hironaokato/atom_rc/README.md

atom_rc
=======

atom 3D Printer based on RepRap

About this printer;

This is "atom" open-source 3D printer based on RepRap project, and the base structure is Prusa i3.

All CAD data is built from scratch in Japan. 

The scale of this printer is Reprap Huxley and print area on XY is same, but Z is bit higher. 

atom aims to fit in small space since most of desktop environment is not that big in Japanese residence.

atom takes this form as a part of RepRap project and is respecting Prusa i3.

Size of bot:  340 x 275 x 270(Z)mm

Print area: 140 x 140 x 140(Z)mm

X-carriage is compatible with Huxley Extruder and its Hotend or Genkei Extruder and its Hotend.

------------------------------------------------------------------

This atom 3D Printer is RC version.
More file format will be coming soon.

------------------------------------------------------------------
x_end and x_motor has two versions which are one-piece and two pieces type.

Use ones you want.

Required mechanical parts list for main body;

M6 Threaded rod: 160mm x4,  275mm x2

M5 Threaded rod: 210mm x2

6mm linear shaft: 270mm x4, 230mm x2

GT2 OR T2.5 Timing Pulley (GT2 20tooth pulley is recommended): x2

GT2 OR T2.5 Timing Belt 6mm width: 580mm x1(X), 475mm x1(Y), these lentghs are for GT2 20tooth pulley.

Aluminum or Wood square frame: x1

Aluminum or Wood Y frog frame: x1

Teflon Bush 6mm(in) 8mm(out): x8 (if you want to use linear bearings on Y axis, then please subtract 4pcs, total 4pcs)

LM6UU Linear Bush: x4 (if you want to use linear bearings on Y axis, then please add 4pcs, total 8pcs)

624ZZ Radial Bearing: x2

M3 Nut x61minimum (+2for Genkei Extruder)

M3 washer x10

M3 10mm x38

M3 15mm x14

M3 20mm x2 (+2for Genkei Extruder)

M3 30mm x2 (+3for Genkei Extruder)

M3 Super Flat 16mm x4

M4 Nut x2

M4 washer x4

M4 25mm x2

M5 Nut x2

M6 Nut x36

M6 washer xmin4 (4 wider washers for holding sqaure frame and Y axis.)

Required Extruder and hotend;

atom can use Huxley bowden extruder hotend set OR Genkei bowden extruder hotend set in default.

------------------------------------------------------------------

RepRap official: http://www.reprap.org

RepRap Community Japan on Facebook: https://www.facebook.com/ReprapCommunityJapan

RepRap Community Japan on Mixi:  http://c.mixi.jp/reprap 

RepRap Community Japan Archive:  https://sites.google.com/site/reprapcommunityjapan/

Prusa i3 Github:  https://github.com/josefprusa/Prusa3
