hironaokato/atom_rc/dxf/bed.DXF

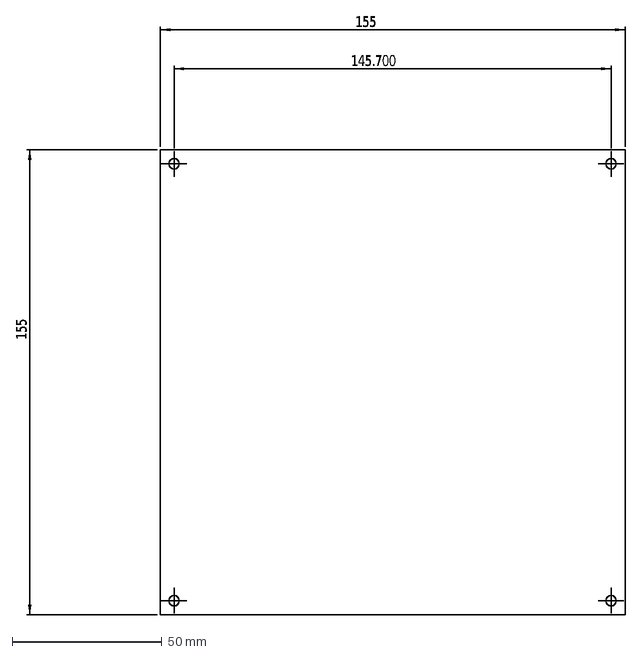
[picture p1: CAD file, 2013-06-01]
dxf/bed.DXF
155
145.700
