hironaokato/atom_rc/iges/y_end_c.IGS

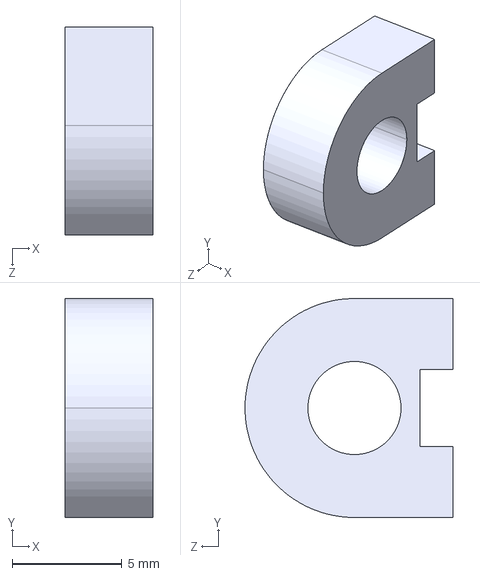
[picture p2: CAD file, 2013-11-18]
iges/y_end_c.IGS
4.00 x 10.0 x 9.50 mm
