hironaokato/atom_rc/step/DD_carriage_for_atom.STEP

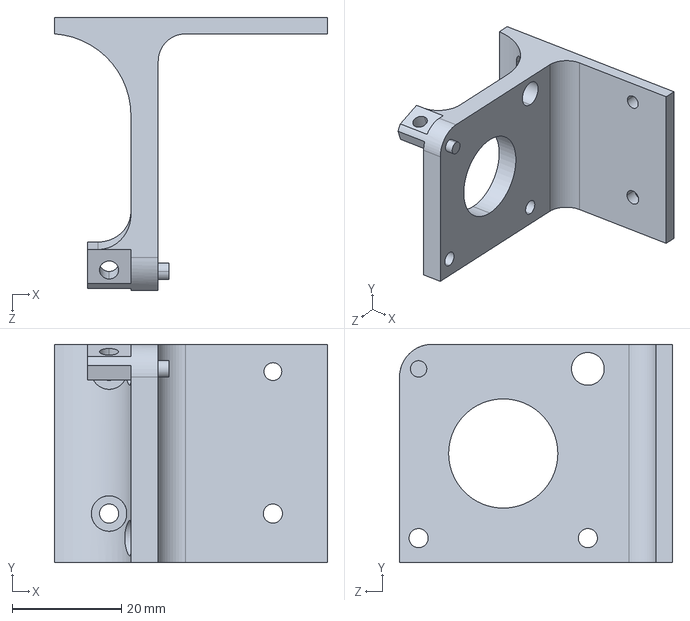
[picture p3: CAD file, 2013-11-18]
step/DD_carriage_for_atom.STEP
50.0 x 40.0 x 50.0 mm
