hironaokato/atom_rc/dxf/square_frame.DXF

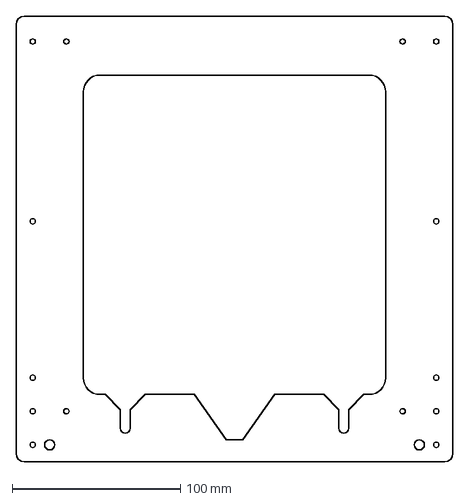
[picture p4: CAD file, 2013-06-01]
dxf/square_frame.DXF
260.0 x 265.0 mm
