hironaokato/atom_rc/iges/endstops.IGS

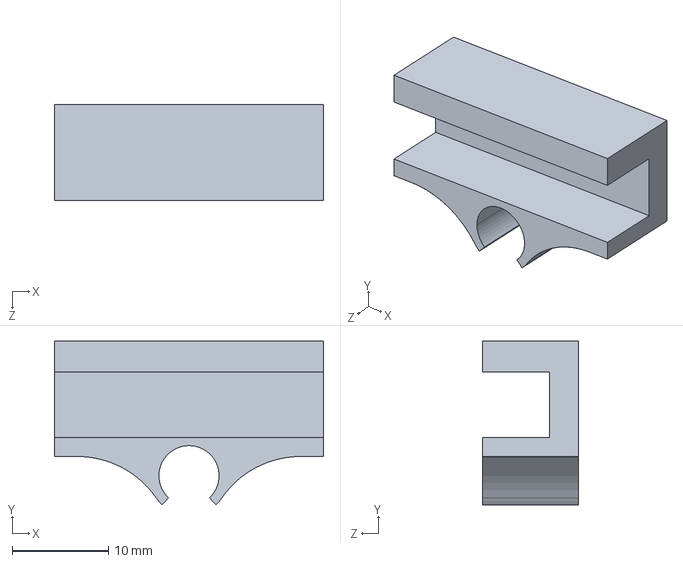
[picture p5: CAD file, 2013-11-18]
iges/endstops.IGS
28.0 x 17.0 x 10.0 mm
