hironaokato/atom_rc/step/y_belt_cramper_b_2.STEP

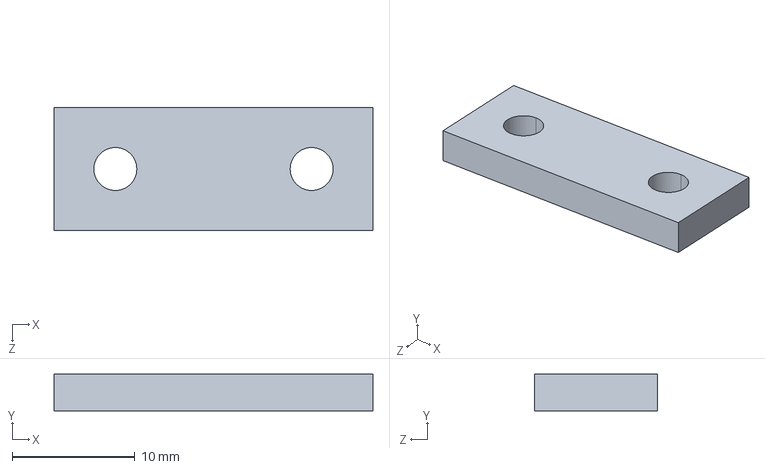
[picture p6: CAD file, 2013-06-24]
step/y_belt_cramper_b_2.STEP
26.0 x 3.00 x 10.0 mm
