hironaokato/atom_rc/dxf/y_frog.DXF

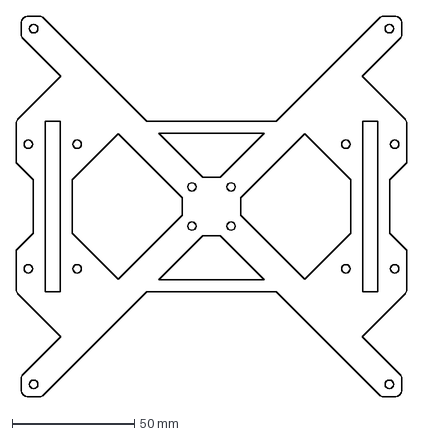
[picture p7: CAD file, 2013-06-01]
dxf/y_frog.DXF
160.0 x 155.7 mm
