hironaokato/atom_rc/iges/y_foot.IGS

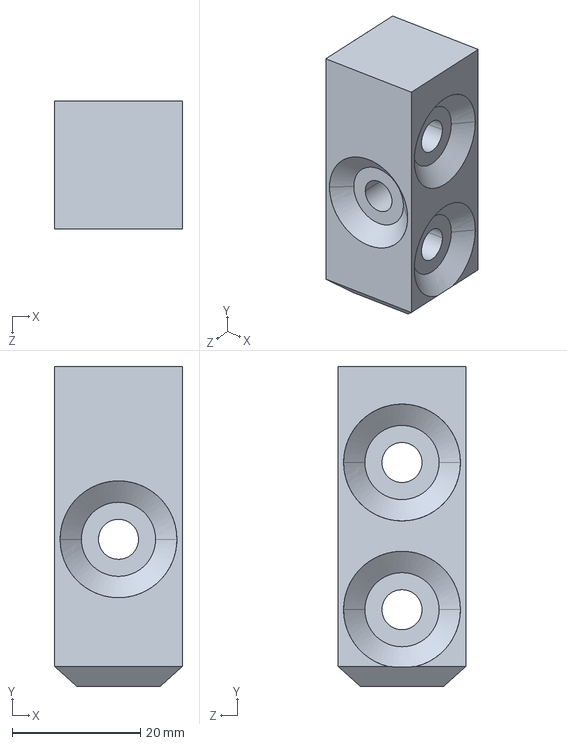
[picture p8: CAD file, 2013-11-18]
iges/y_foot.IGS
20.0 x 50.0 x 20.0 mm
