hironaokato/atom_rc/step/x_motor split_a.STEP

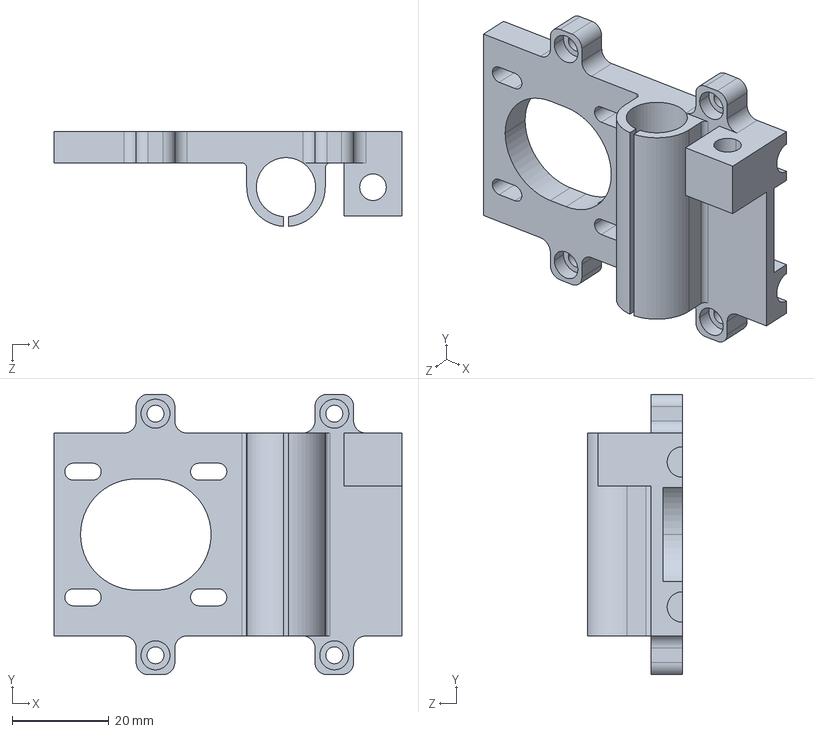
[picture p9: CAD file, 2013-06-24]
step/x_motor split_a.STEP
72.0 x 58.0 x 19.6 mm
