hironaokato/atom_rc/stl/X_carriage_lm_ver_c.STL

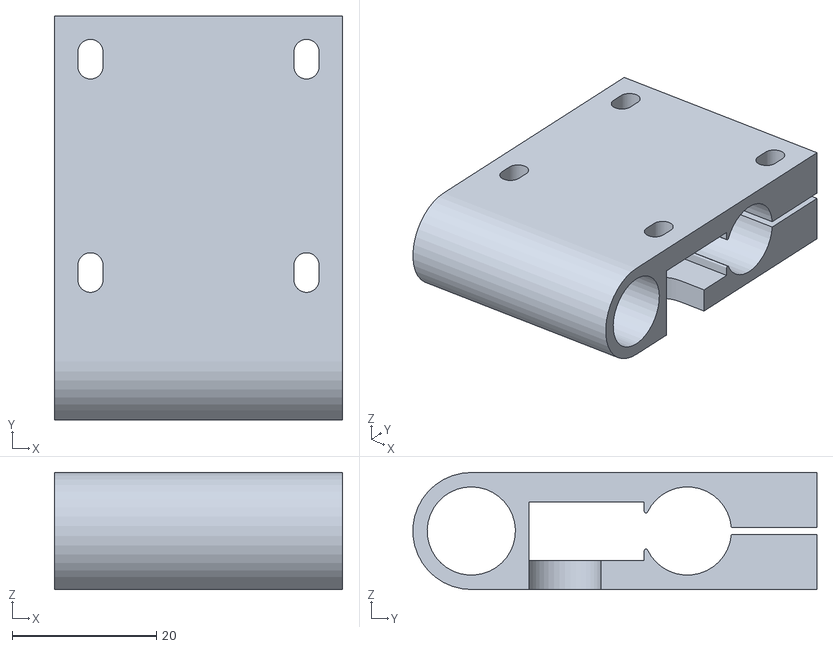
[picture p10: CAD file, 2014-03-04]
stl/X_carriage_lm_ver_c.STL
40.0 x 56.1 x 16.2
