hironaokato/atom_rc/iges/z_couple.IGS

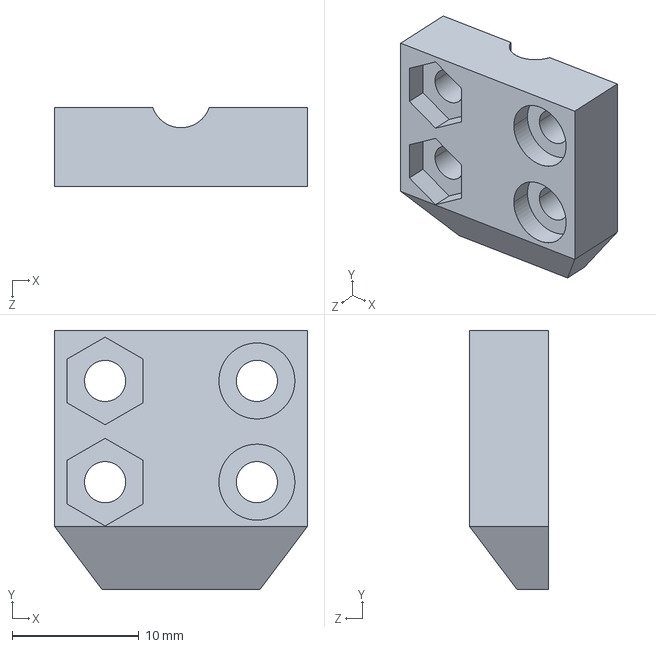
[picture p11: CAD file, 2013-11-18]
iges/z_couple.IGS
20.0 x 20.5 x 6.25 mm
