hironaokato/atom_rc/step/x_motor.STEP

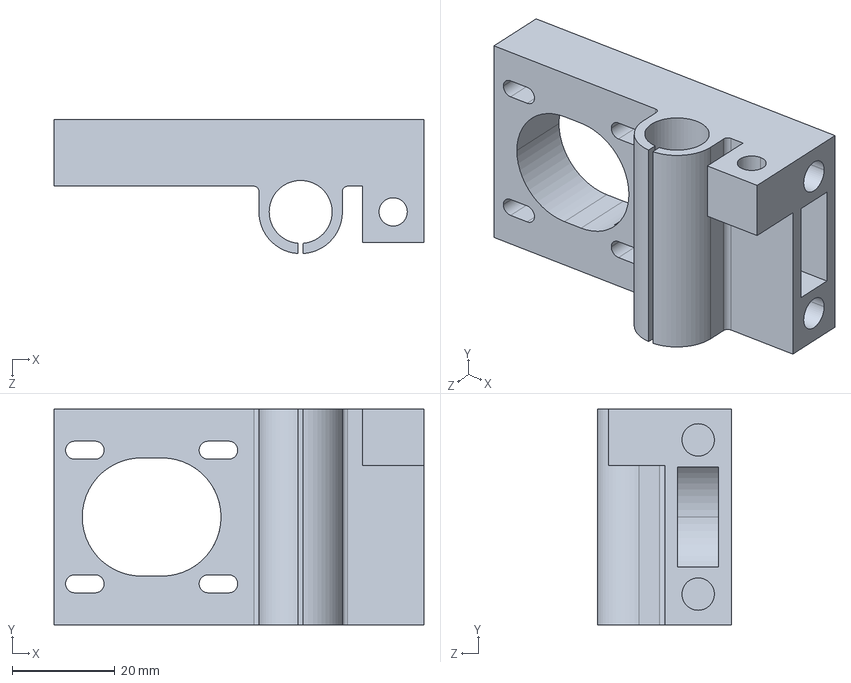
[picture p12: CAD file, 2013-06-24]
step/x_motor.STEP
72.0 x 42.0 x 26.1 mm
