hironaokato/atom_rc/stl/y_bush_holder_rimless.STL

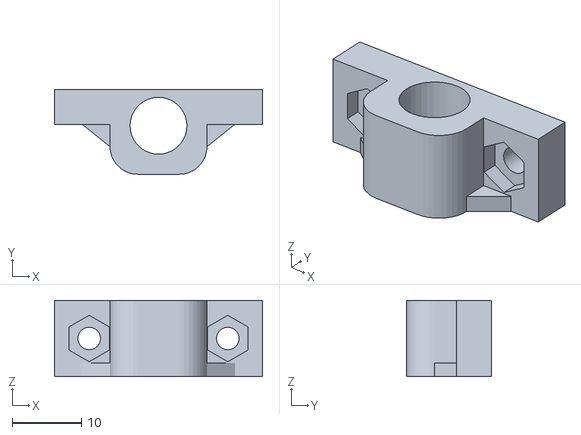
[picture p13: CAD file, 2013-06-02]
stl/y_bush_holder_rimless.STL
30.0 x 12.2 x 11.0
