hironaokato/atom_rc/step/z_end_left.STEP

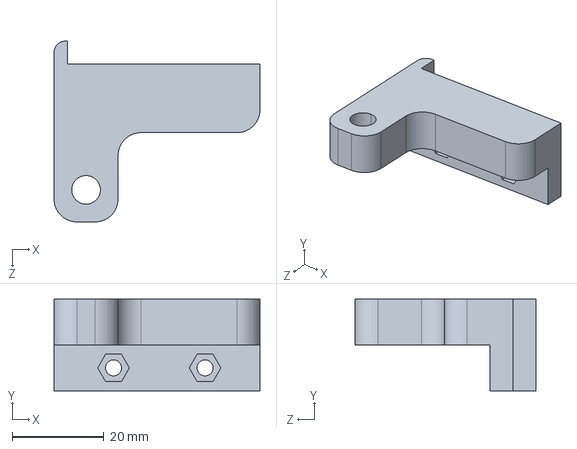
[picture p14: CAD file, 2013-06-24]
step/z_end_left.STEP
45.0 x 20.0 x 39.5 mm
