hironaokato/atom_rc/stl/x_end.STL

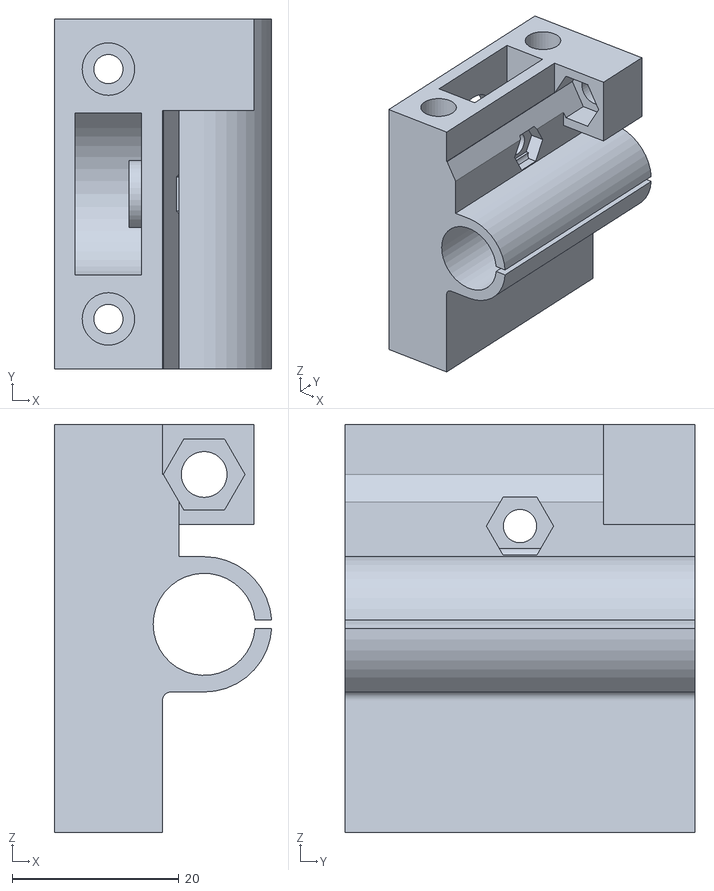
[picture p15: CAD file, 2013-06-02]
stl/x_end.STL
26.1 x 42.0 x 49.0
