hironaokato/atom_rc/iges/y_bush_holder.IGS

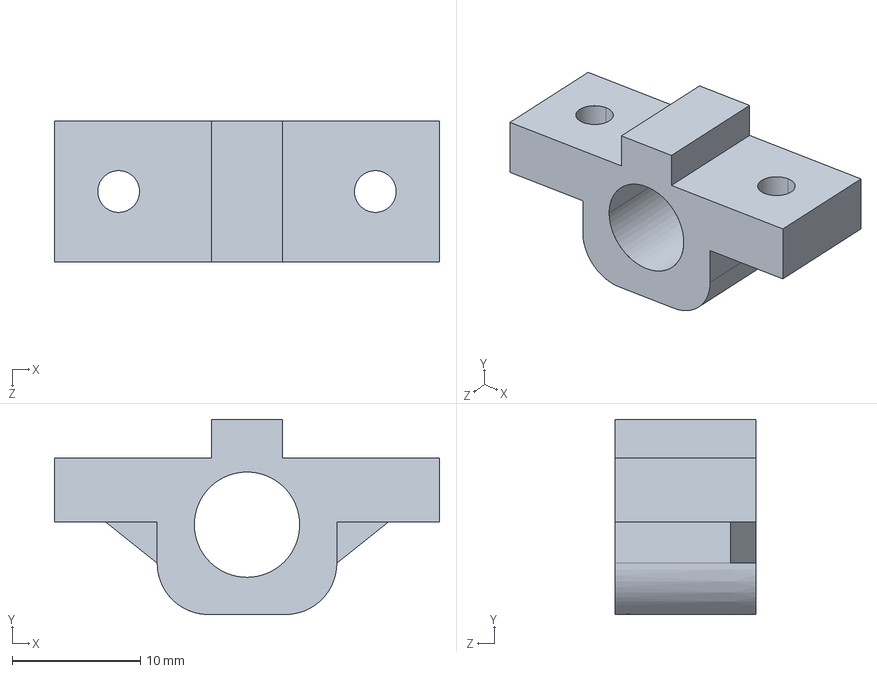
[picture p16: CAD file, 2013-11-18]
iges/y_bush_holder.IGS
30.0 x 15.2 x 11.0 mm
