hironaokato/atom_rc/step/x_carriage_b.STEP

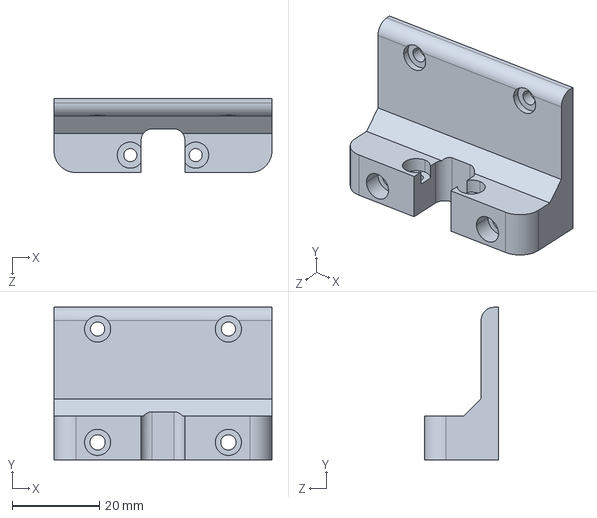
[picture p17: CAD file, 2013-06-24]
step/x_carriage_b.STEP
50.0 x 35.0 x 17.0 mm
