hironaokato/atom_rc/stl/atom_rc_assem.STL

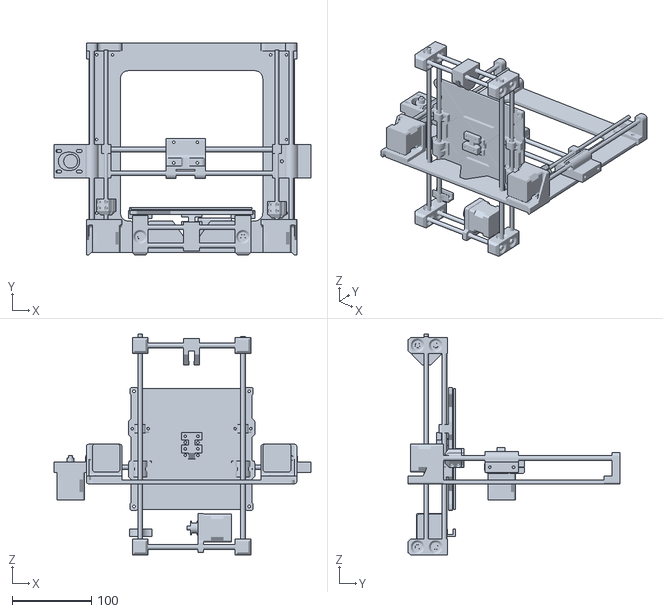
[picture p18: CAD file, 2013-05-15]
stl/atom_rc_assem.STL
325.0 x 268.0 x 279.4
