hironaokato/atom_rc/iges/y_belt_clamper_a.IGS

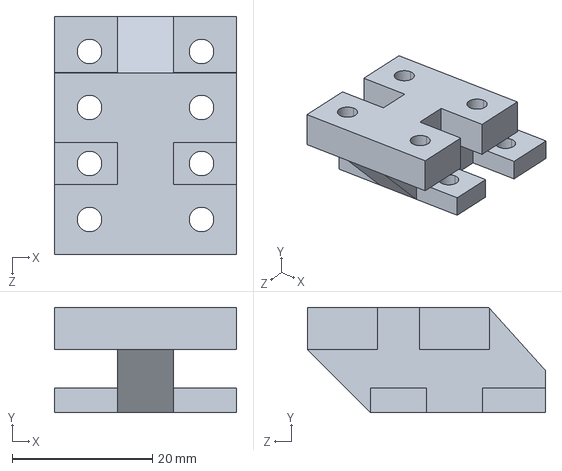
[picture p19: CAD file, 2013-11-18]
iges/y_belt_clamper_a.IGS
26.0 x 15.0 x 34.0 mm
