hironaokato/atom_rc/step/y_end_a.STEP

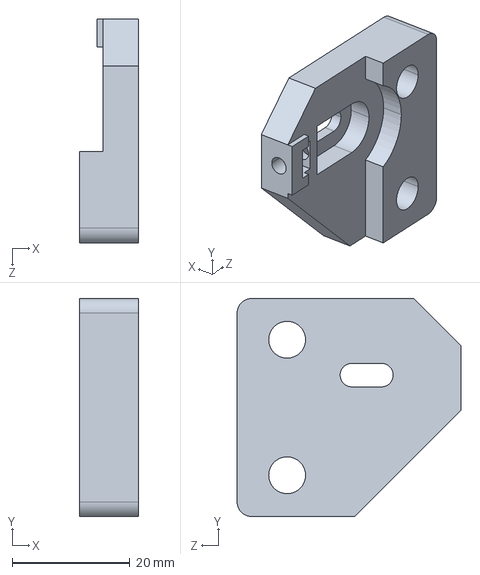
[picture p20: CAD file, 2013-06-24]
step/y_end_a.STEP
10.0 x 37.0 x 38.0 mm
