hironaokato/atom_rc/stl/y_lmbush_holder.STL

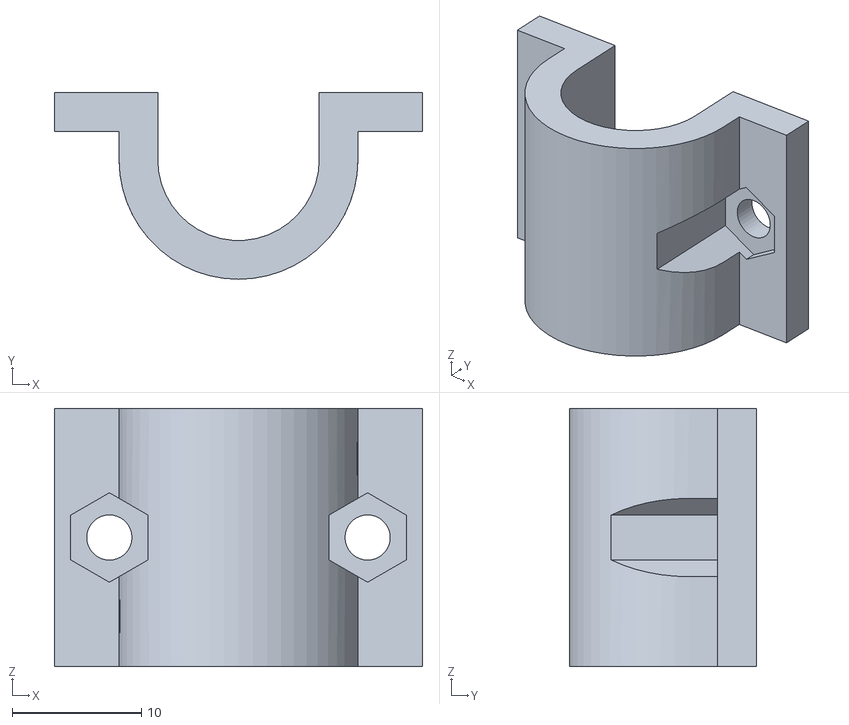
[picture p21: CAD file, 2013-05-13]
stl/y_lmbush_holder.STL
28.5 x 14.4 x 20.0
