hironaokato/atom_rc/step/x_end split_a.STEP

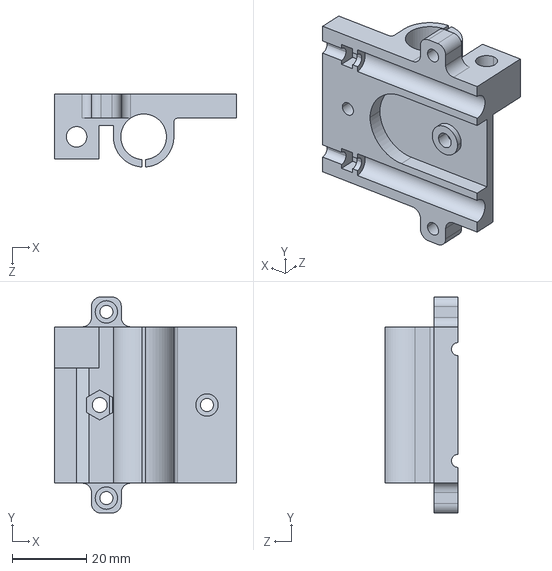
[picture p23: CAD file, 2013-06-24]
step/x_end split_a.STEP
49.0 x 58.0 x 19.6 mm
