hironaokato/atom_rc/step/x_end_b.STEP

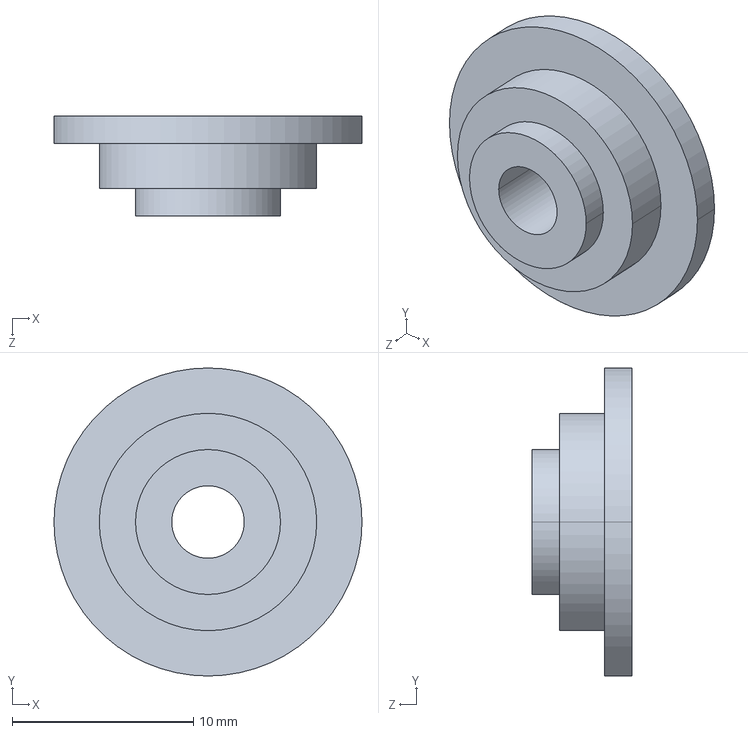
[picture p24: CAD file, 2013-06-24]
step/x_end_b.STEP
17.0 x 17.0 x 5.50 mm
