hironaokato/atom_rc/step/x_carriage_a.STEP

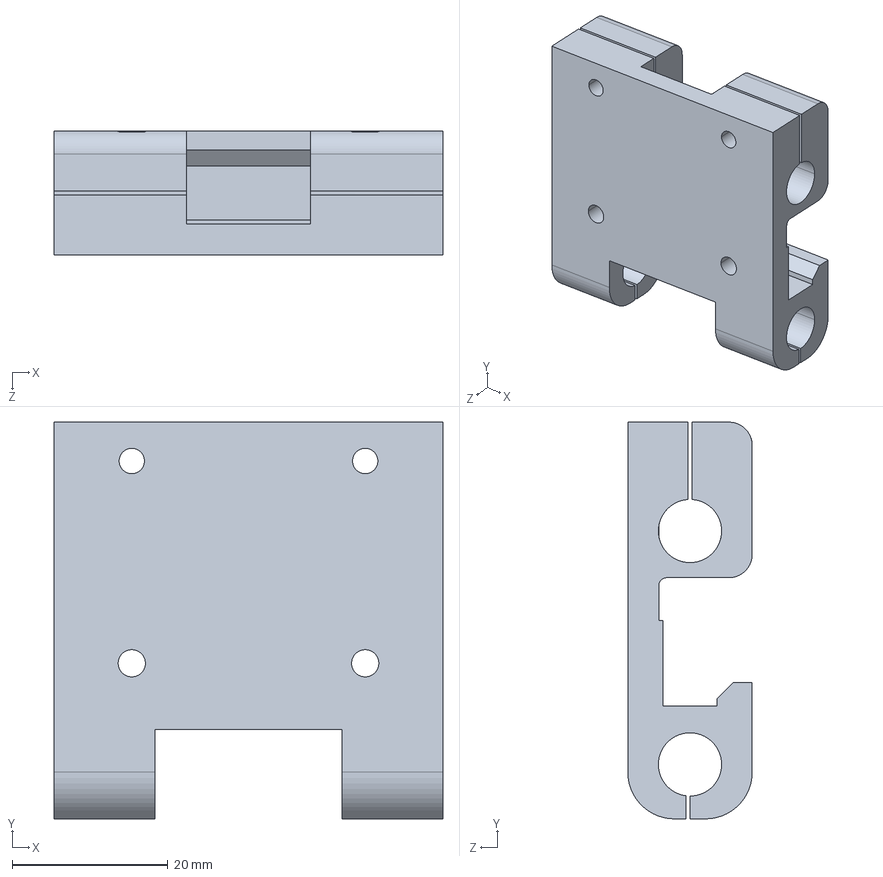
[picture p26: CAD file, 2013-06-24]
step/x_carriage_a.STEP
50.0 x 51.0 x 16.0 mm
