hironaokato/atom_rc/step/z_couple_4.STEP

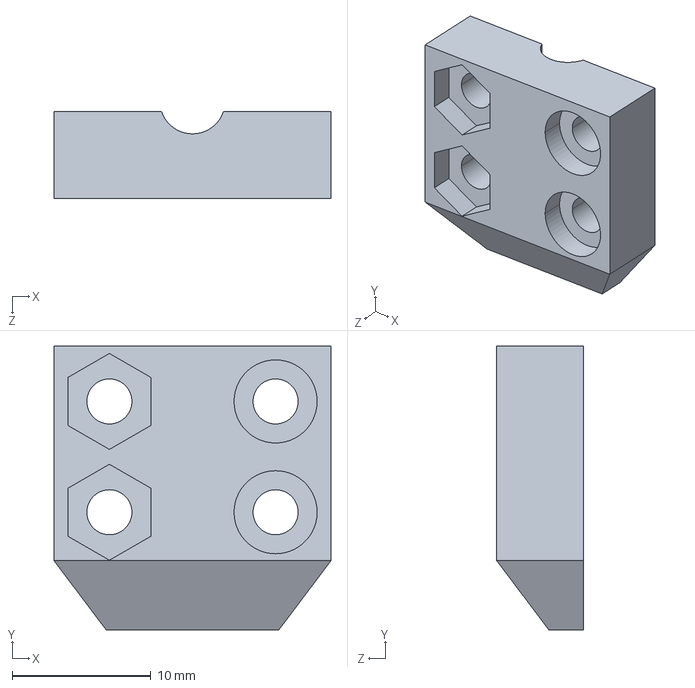
[picture p27: CAD file, 2013-06-24]
step/z_couple_4.STEP
20.0 x 20.5 x 6.25 mm
