hironaokato/atom_rc/step/x_carriage_c.STEP

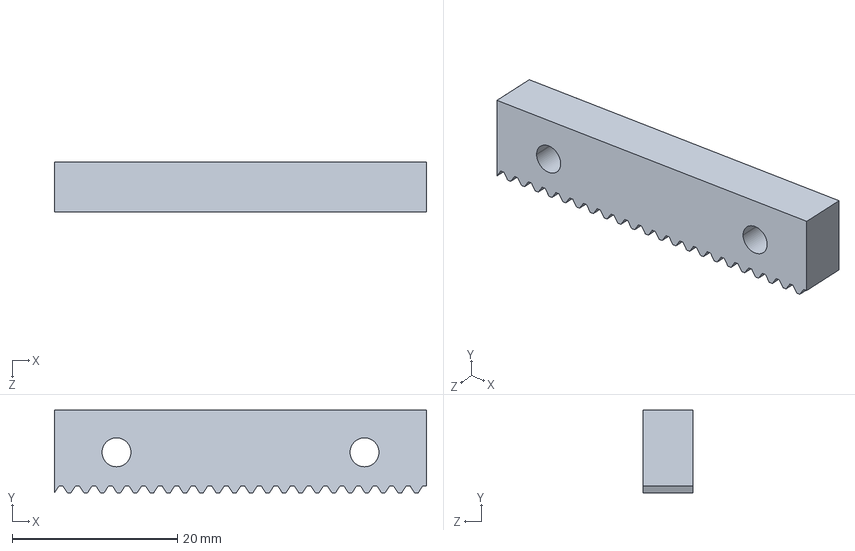
[picture p28: CAD file, 2013-06-24]
step/x_carriage_c.STEP
45.0 x 10.0 x 6.00 mm
