hironaokato/atom_rc/step/y_motor.STEP

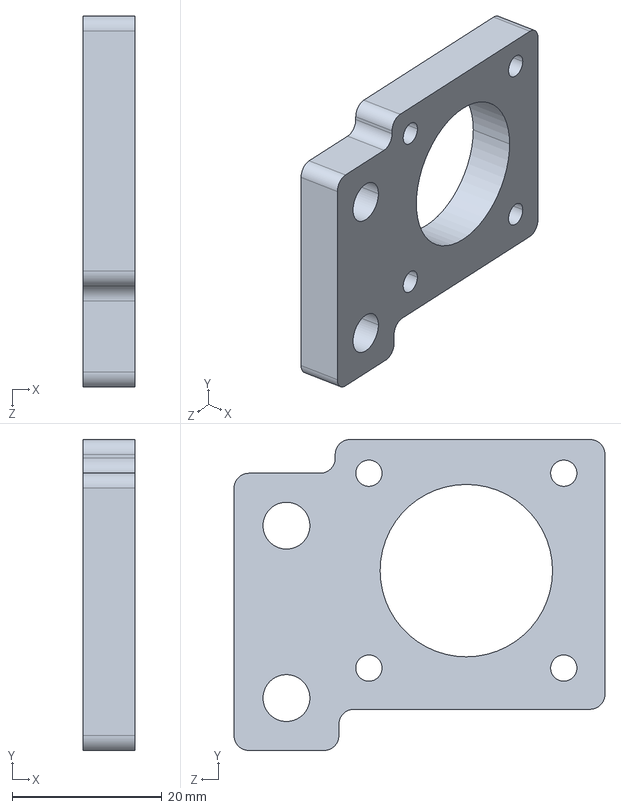
[picture p29: CAD file, 2013-06-24]
step/y_motor.STEP
7.00 x 41.5 x 49.5 mm
