hironaokato/atom_rc/step/x_end split_b.STEP

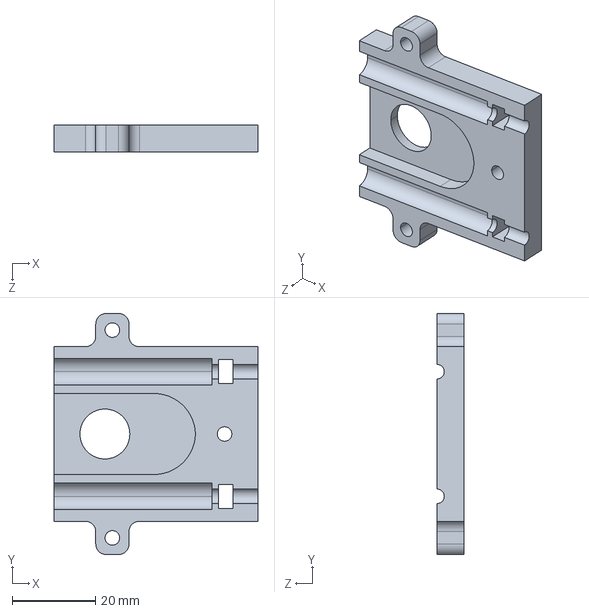
[picture p30: CAD file, 2013-06-24]
step/x_end split_b.STEP
49.0 x 58.0 x 6.50 mm
