hironaokato/atom_rc/step/Spring Holder DD Extruder.STEP

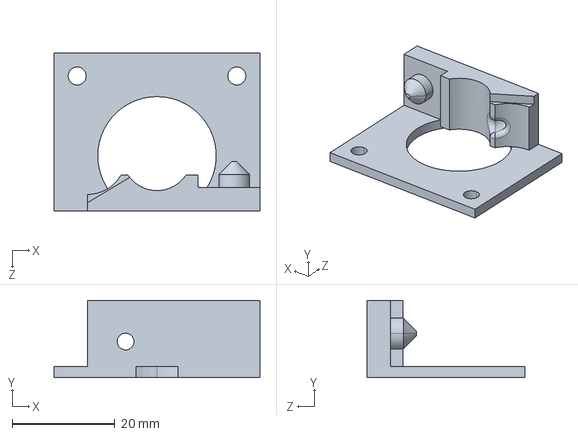
[picture p31: CAD file, 2013-06-24]
step/Spring Holder DD Extruder.STEP
40.0 x 15.0 x 30.8 mm
