hironaokato/atom_rc/step/x_motor split_b.STEP

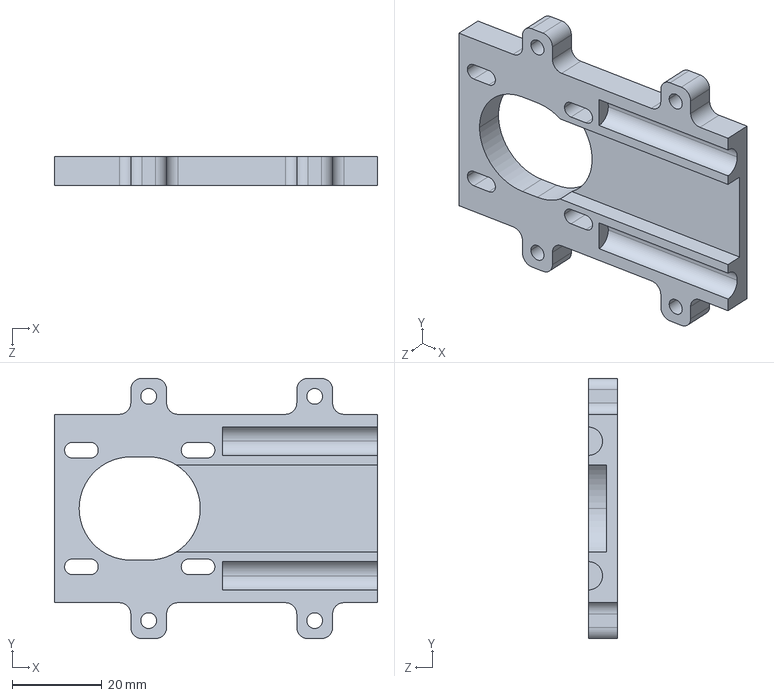
[picture p32: CAD file, 2013-06-24]
step/x_motor split_b.STEP
72.0 x 58.0 x 6.50 mm
