hironaokato/atom_rc/(list of files, cad)

Other CAD files:
iges/y_belt_clamper_b.IGS
step/y_foot_4.STEP
step/y_end_b.STEP
step/x_end_a.STEP
step/z_end_right.STEP
step/y_end_c_2.STEP
step/y_belt_cramper_a.STEP
step/z_motor_right.STEP
step/endstops_4.STEP
step/y_bush_holder_4.STEP
iges/x_carriage_a.IGS
iges/x_carriage_b.IGS
iges/x_carriage_c.IGS
iges/x_end a.IGS
iges/x_end b.IGS
iges/x_motor.IGS
iges/y_end_a.IGS
iges/y_end_b.IGS
iges/y_motor.IGS
iges/z_end_left.IGS
iges/z_end_right.IGS
iges/z_motor_left.IGS
iges/z_motor_right.IGS
stl/DD_carriage_for_atom.STL
stl/X_carriage_lm_ver_a.STL
stl/X_carriage_lm_ver_b.STL
stl/endstops.STL
stl/x_carriage_a.STL
stl/x_carriage_b.STL
stl/x_carriage_c.STL
stl/x_end_b.STL
stl/x_motor.STL
stl/y_belt_clamper_a.STL
stl/y_belt_clamper_b.STL
stl/y_bush_holder.STL
stl/y_end_a.STL
stl/y_end_b.STL
stl/y_end_c.STL
stl/y_foot.STL
stl/y_motor.STL
stl/z_couple.STL
stl/z_end_left.STL
stl/z_end_right.STL
stl/z_motor_left.STL
stl/z_motor_right.STL
