hironaokato/atom_rc/pdf/square_frame.PDF

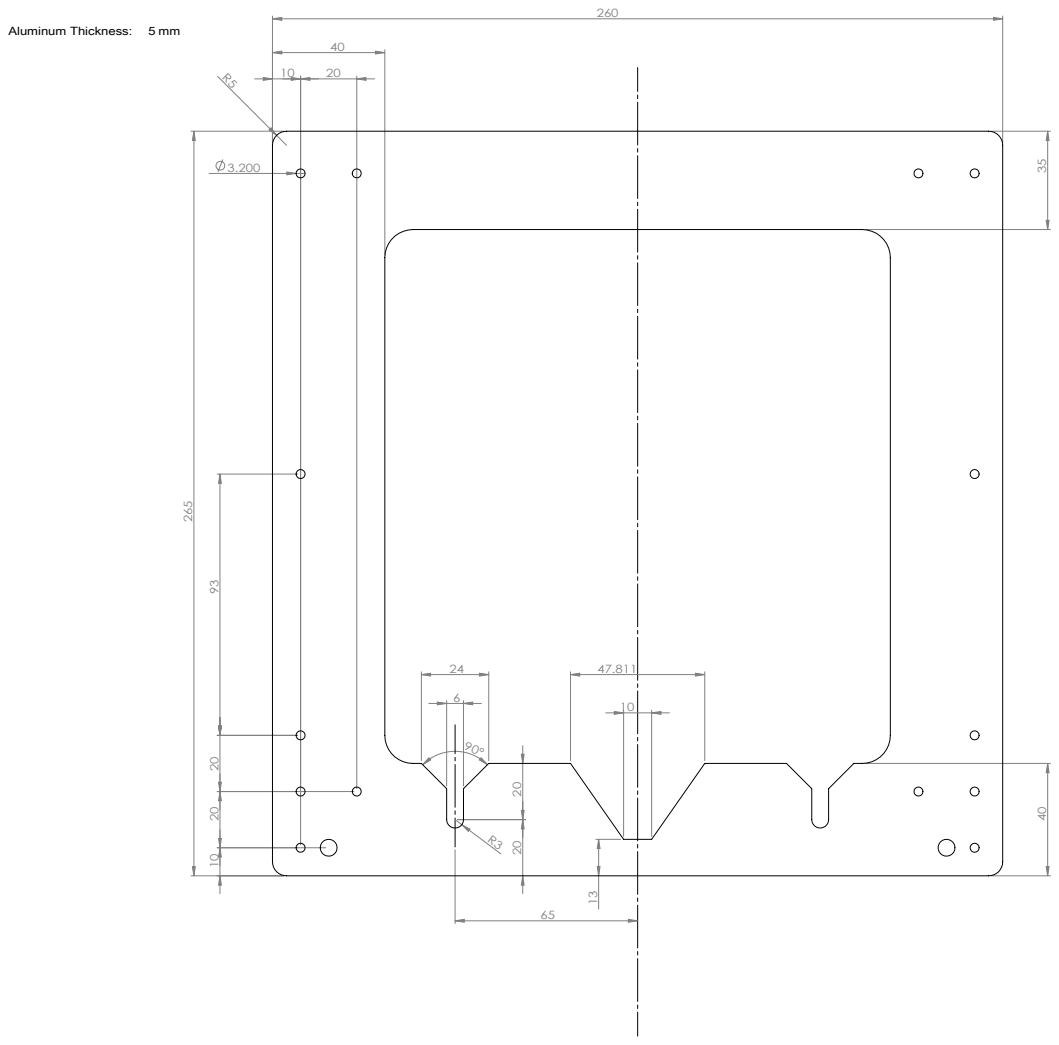
[picture p33: page 1]
Aluminum Thickness: ５mm
