hironaokato/atom_rc/pdf/jig_050713.pdf

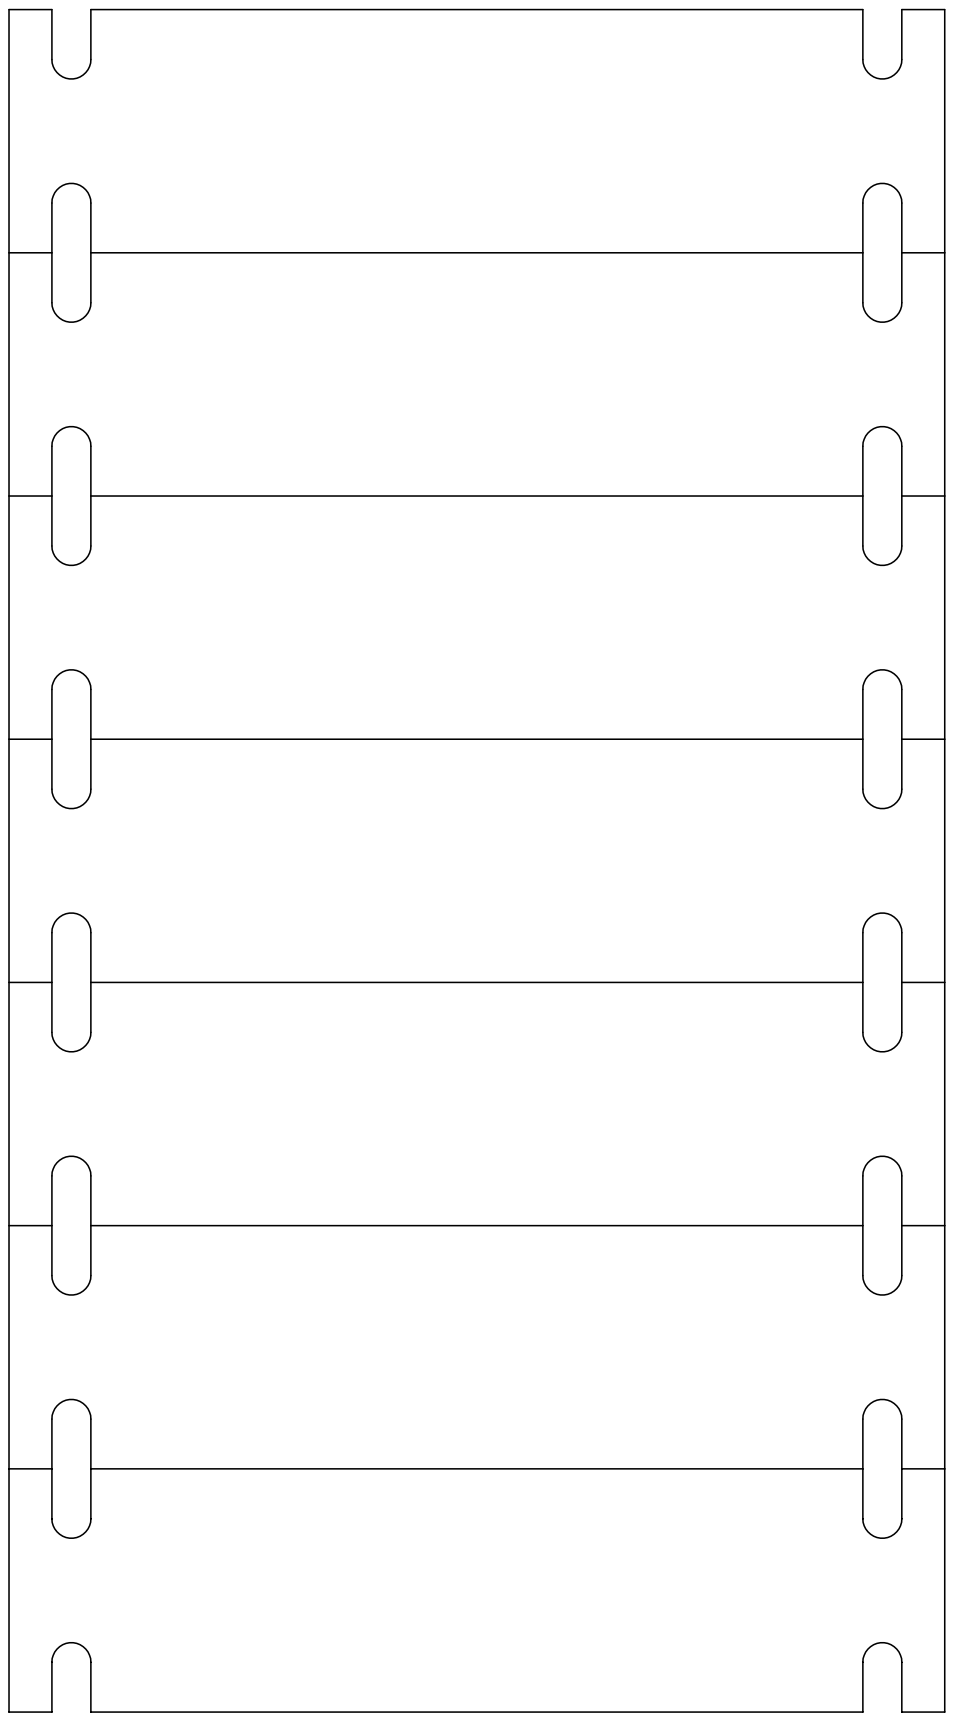
[picture p34: page 1]
