hironaokato/atom_rc/(commit log)

2013-05-13 First Upload
    [endstops.STL, x_carriage_a.STL, x_carriage_b.STL, x_carriage_c.STL, x_end.STL, x_end_b.STL, x_motor.STL, y_belt_cramper_a.STL]
2013-05-15 chamfer updated
    [y_foot.STL]
2013-05-19 new one! please use this.
    [y_end_a.STL]
2013-05-19 updated! please use these
    [y_end_a.STL, y_end_b.STL, y_end_c.STL]
2013-06-02 bit changed, now cut belt will go through
    [x_end.STL]
2013-06-02 added for non-laser cut user
    [y_bush_holder_rimless.STL]
2013-06-10 Spell check man! Spell check!
    [y_belt_clamper_a.STL, y_belt_clamper_b.STL]
2013-06-24 STEP files!
    [Spring Holder DD Extruder.STEP, endstops_4.STEP, x_carriage_a.STEP, x_carriage_b.STEP, x_carriage_c.STEP, x_end split_a.STEP, x_end split_b.STEP, x_end_a.STEP]
2013-12-27 Linear Bearing Version of X carriage
    [X_carriage_lm_ver_a.STL, X_carriage_lm_ver_b.STL, X_carriage_lm_ver_c.STL]
